JasonStoyanov/athena_pcb/README.adoc

= Athena Project PCB
:hardbreaks-option:

Additional information regarding the hardware can be found in the following article:
https://open4tech.com/how-to-create-a-ble-sensor-beacon-part-1-the-hardware/
