JasonStoyanov/athena_pcb/athena_pcb.xlsx

# | Reference | Qty | Value | Footprint | DNP | Description | MANUFACTURER | MPN | Package
1 | AE1 | 1 | Antenna | RF_Antenna:Texas_SWRA117D_2.4GHz_Right |  | PCB antenna | N.A | N.A | N.A
2 | BT1 | 1 | Battery_Cell | Battery:BatteryHolder_Keystone_1060_1x2032 |  | Bat Holder CR2032 SMD | Keystone | 1060
3 | C1, C2, C4, C5, C7 | 5 | 1uF | Capacitor_SMD:C_0402_1005Metric |  | Capacitor, Ceramic, X5R, ±10%, 25V | Murata | GRM155R61E105KA12D | 0402
4 | C3 | 1 | 2.2nF | GRM033R71C301JA01D:CAPC0603X33N |  | Capacitor, Ceramic, X5R, ±10%, 10V | Murata | GRM033R61A222KA01D | 0201
5 | C6, C8, C9, C10, C11, C13, C14, C15, C16, C18, C19 | 11 | 100nF | GRM033R71C301JA01D:CAPC0603X33N |  | Capacitor, Ceramic, X5R, ±10%, 6.3V | Murata | GRM033R60J104KE19D | 0201
6 | C12 | 1 | 0.7pF | GRM033R71C301JA01D:CAPC0603X33N |  | Capacitor, NP0, ±0.05pF | Murata | GJM0335C1HR70WB01D | 0201
7 | C17 | 1 | N.C | GRM033R71C301JA01D:CAPC0603X33N | DNP | Not mounted/DNP | N.A | N.A | 0201
8 | D1 | 1 | LED | LED_SMD:LED_0603_1608Metric |  | Green LED SMD WL-SMCD | Wurth Electronic | 150060VS55040 | 0603
9 | J2 | 1 | Conn_01x04 | Connector_PinSocket_1.27mm:PinSocket_1x06_P1.27mm_Vertical | DNP | Not mounted/DNP | N.A | N.A | N.A
10 | L1, L2 | 2 | 10uH | LQM18DN100M70L:INDC1608X95N |  | Inductor, 100mA, ±20%, 1.05Ohm | Murata | LQM18DN100M70L | 0603
11 | L3 | 1 | 2.2nH | LQP03HQ2N2B02D:IND_LQP03HQ2N2B02D |  | Inductor, 600mA, ±0.1ｎH, 120mOhm | Murata | LQP03HQ2N2B02D | 0201
12 | R1 | 1 | 200R | Resistor_SMD:R_0402_1005Metric |  | Resistor, ±1%, 62.5 mW | YAGEO | RC0402FR-13200RL | 0402
13 | SW1 | 1 | SW_Push | Button_Switch_SMD:SW_Push_1P1T_NO_CK_KMR2 |  | Tactile Switch SMD | C&K Switches | KMR221NGLFS
14 | TP1, TP2, TP3, TP4 | 4 | TestPoint | TestPoint:TestPoint_Pad_D1.0mm |  | Test point pad | N.A | N.A | N.A
15 | U1 | 1 | NRF5340-QKAA-R7 | NRF5340-QKAA-R7:XCVR_NRF5340-QKAA-R7 |  | Multi-protocol Bluetooth Low Energy system-on-chip | Nordic Semiconductor | nRF5340-QKAA-R7 | aQFN-94
16 | U2 | 1 | BME280 | Package_LGA:Bosch_LGA-8_2.5x2.5mm_P0.65mm_ClockwisePinNumbering |  | BME280 temp and humidity sensor | Bosch Sensortec | BME280 | LGA-8
17 | Y1 | 1 | 32MHz | XRCGB32M000F1H19R0:OSC_XRCGB32M000F1H19R0 |  | XTAL SMD 2016, 32MHz, Cl=9pF, Tol: ±10ppm, Stab: ±10ppm | Murata Electronics | XRCGB32M000F1S1JR0 | XTAL_2016
18 | Y2 | 1 | 32.768kHz | CM8V-T1A-32.768KHZ-9PF-20PPM-TA-QC:XTAL_CM8V-T1A-32.768KHZ-9PF-20PPM-TA-QC |  | XTAL SMD 2012, 32.768kHz, 9pF, ±20ppm | Micro Crystal | CM8V-T1A-32.768kHz-9pF-20PPM-TA-QC | XTAL_2012
