JasonStoyanov/athena_pcb/symbols_footprints/CM8V-T1A-32.768KHZ-9PF-20PPM-TA-QC/CM8V-T1A-32.768KHZ-9PF-20PPM-TA-QC.step

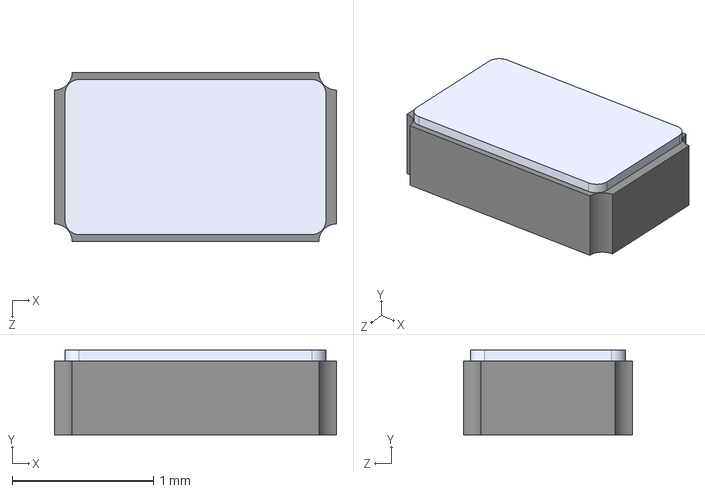
[picture p1: CAD file, 2023-04-21]
symbols_footprints/CM8V-T1A-32.768KHZ-9PF-20PPM-TA-QC/CM8V-T1A-32.768KHZ-9PF-20PPM-TA-QC.step
2.00 x 0.6 x 1.20 mm
