JasonStoyanov/athena_pcb/symbols_footprints/GRM033R71C301JA01D/GRM033R71C301JA01D.step

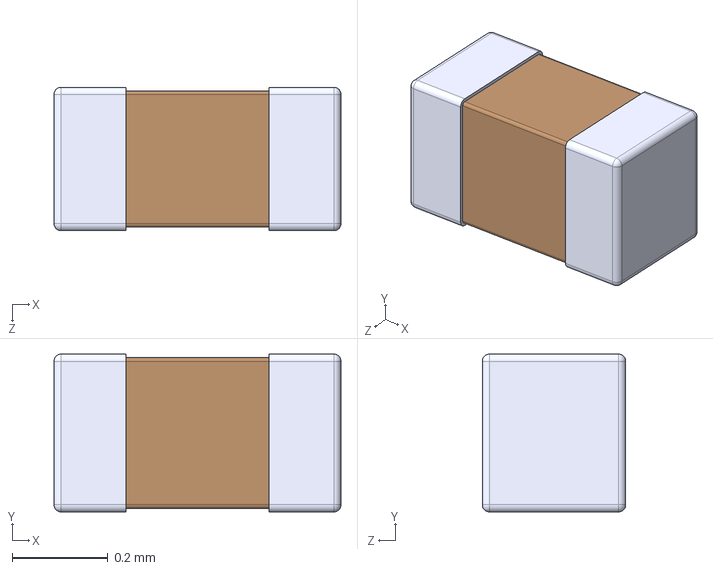
[picture p2: CAD file, 2023-03-07]
symbols_footprints/GRM033R71C301JA01D/GRM033R71C301JA01D.step
0.6 x 0.33 x 0.3 mm
