JasonStoyanov/athena_pcb/symbols_footprints/LQM18DN100M70L/LQM18DN100M70L.step

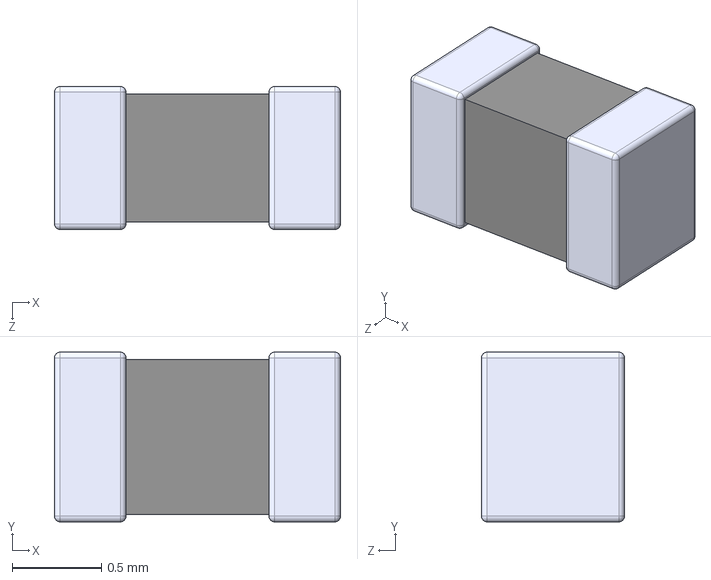
[picture p3: CAD file, 2023-04-21]
symbols_footprints/LQM18DN100M70L/LQM18DN100M70L.step
1.60 x 0.95 x 0.8 mm
