JasonStoyanov/athena_pcb/symbols_footprints/LQP03HQ2N2B02D/LQP03HQ2N2B02D.step

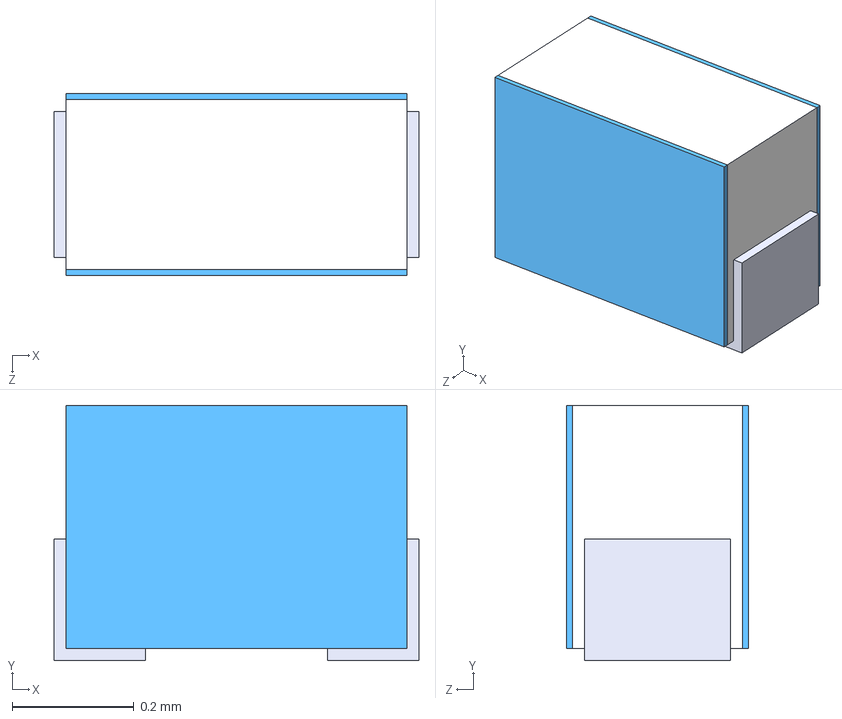
[picture p4: CAD file, 2023-04-21]
symbols_footprints/LQP03HQ2N2B02D/LQP03HQ2N2B02D.step
0.6 x 0.42 x 0.3 mm
