JasonStoyanov/athena_pcb/symbols_footprints/NRF5340-QKAA-R7/NRF5340-QKAA-R7--3DModel-STEP-269445.STEP

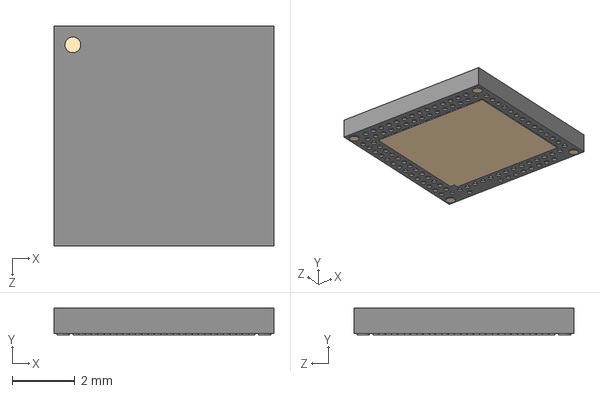
[picture p5: CAD file, 2023-02-18]
symbols_footprints/NRF5340-QKAA-R7/NRF5340-QKAA-R7--3DModel-STEP-269445.STEP
7.00 x 0.85 x 7.00 mm
