JasonStoyanov/athena_pcb/symbols_footprints/XRCGB32M000F1H19R0/XRCGB32M000F1H19R0.step

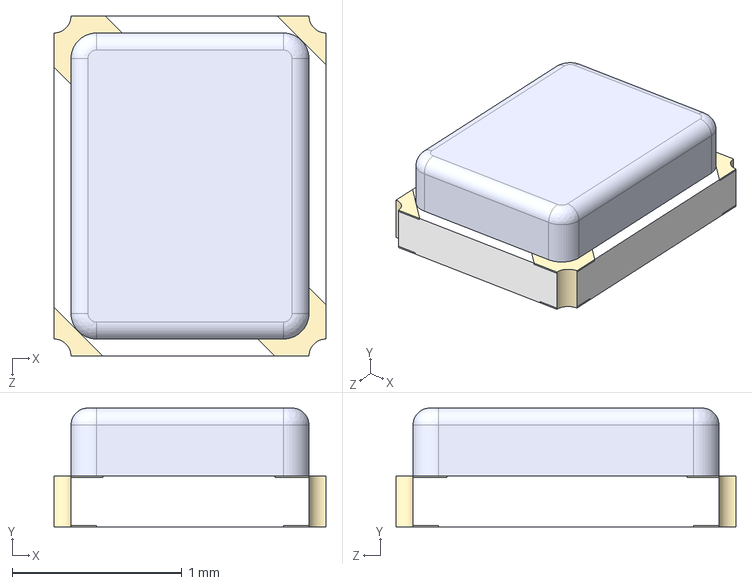
[picture p6: CAD file, 2023-03-25]
symbols_footprints/XRCGB32M000F1H19R0/XRCGB32M000F1H19R0.step
1.60 x 0.7 x 2.00 mm
