JasonStoyanov/athena_pcb/athena_pcb.kicad_pcb

## KiCad design athena_pcb.kicad_pcb (2023-04-21)

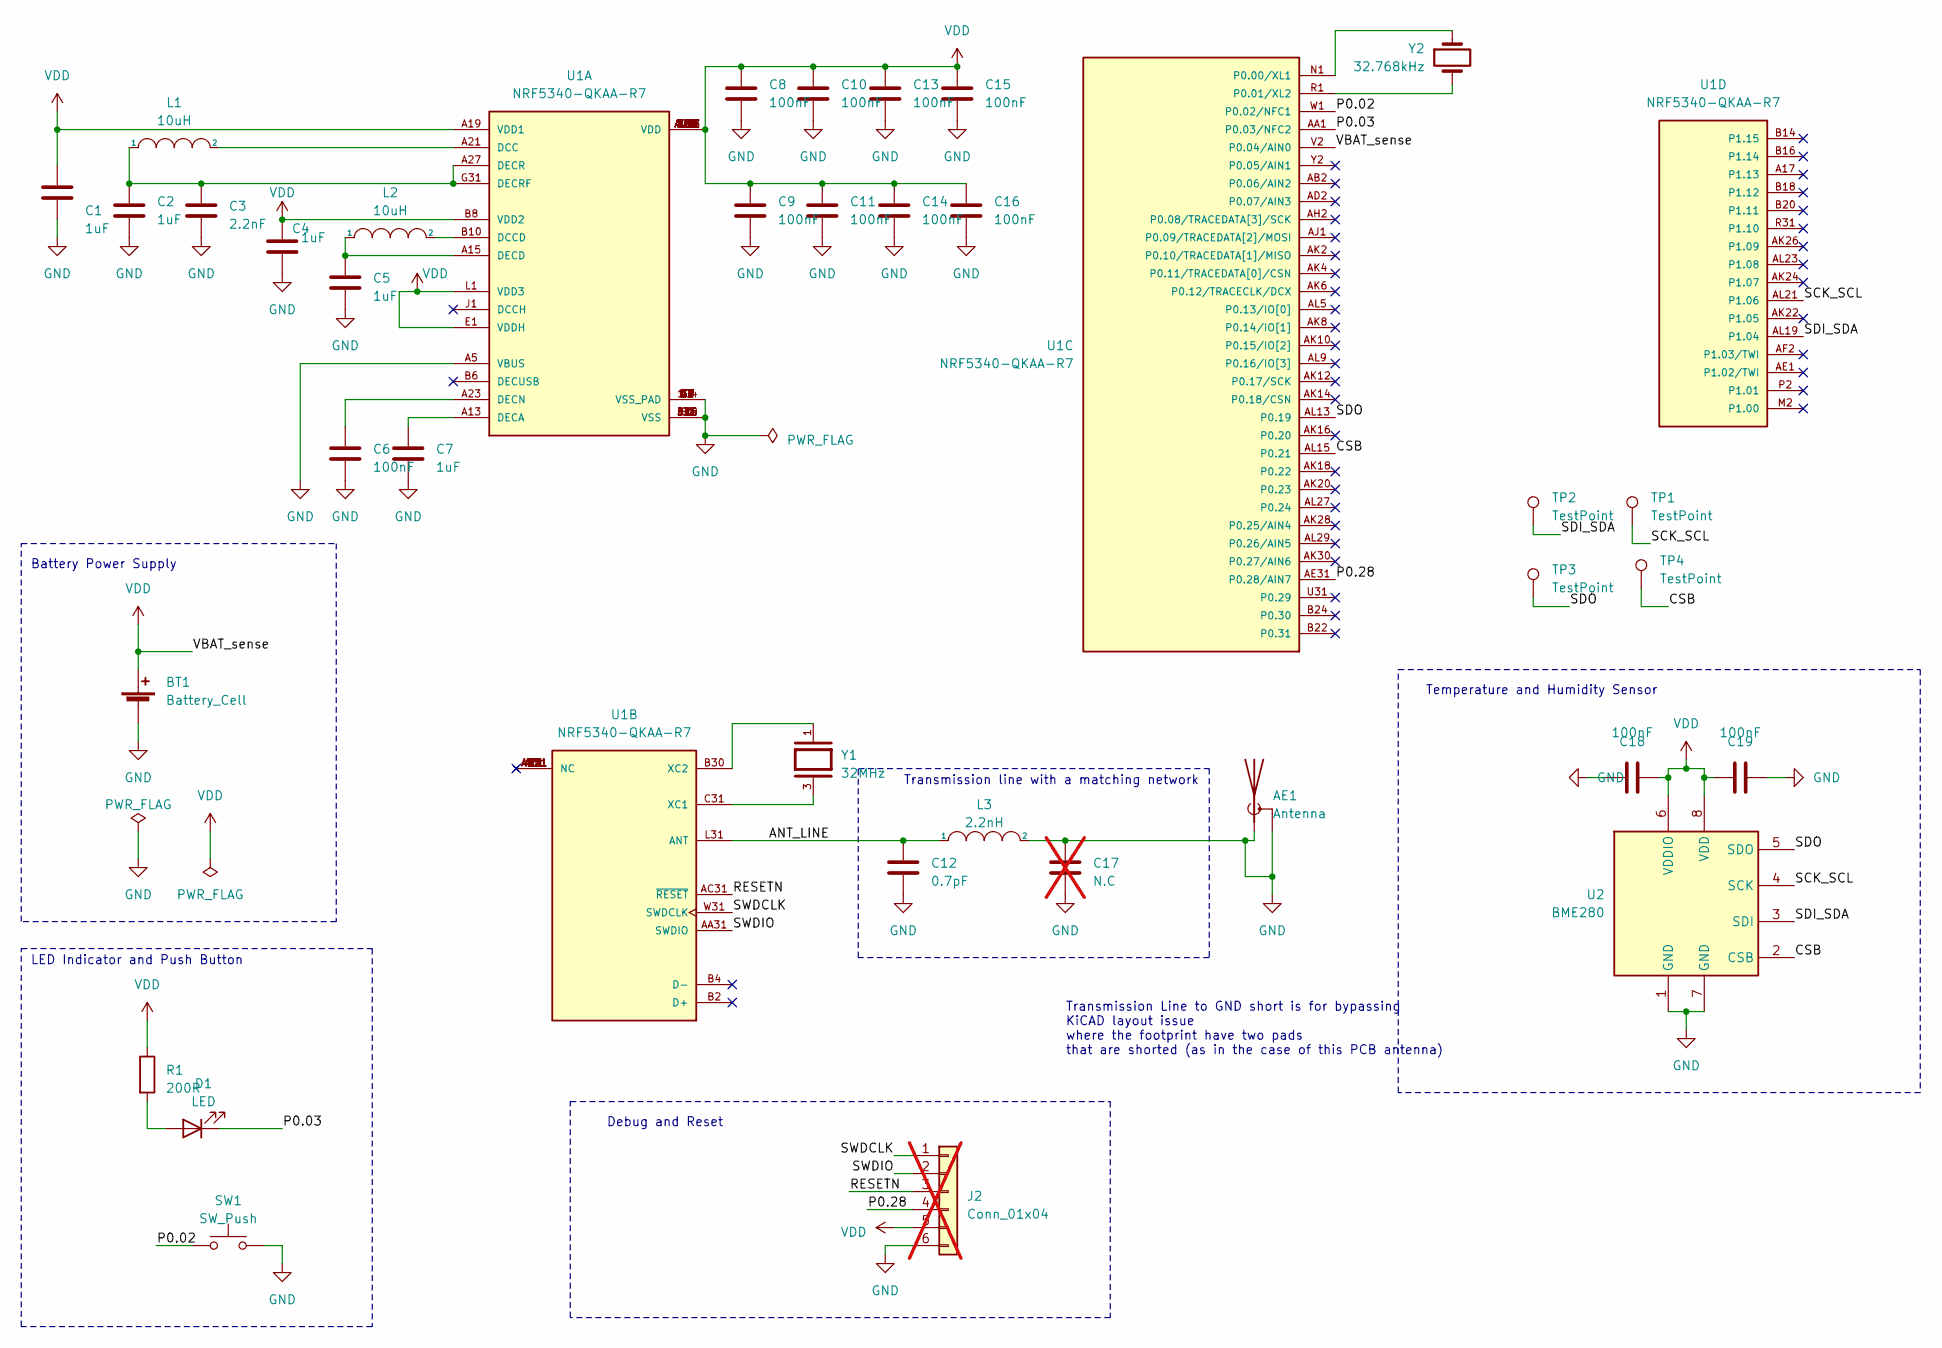
[picture p7: schematic athena_pcb.kicad_sch, Project Athena]

Parts:
AE1: Antenna; Texas_SWRA117D_2.4GHz_Right; MPN N.A
BT1: Battery_Cell; BatteryHolder_Keystone_1060_1x2032; MPN 1060
C1, C2, C4, C5, C7: 1uF; C_0402_1005Metric; MPN GRM155R61E105KA12D
C3: 2.2nF; CAPC0603X33N; MPN GRM033R61A222KA01D
C6, C8, C9, C10, C11, C13, C14, C15, C16, C18, C19: 100nF; CAPC0603X33N; MPN GRM033R60J104KE19D
C12: 0.7pF; CAPC0603X33N; MPN GJM0335C1HR70WB01D
C17: N.C; CAPC0603X33N; MPN N.A; not fitted
D1: LED; LED_0603_1608Metric; MPN 150060VS55040
J2: Conn_01x04; PinSocket_1x06_P1.27mm_Vertical; MPN N.A; not fitted
L1, L2: 10uH; INDC1608X95N; MPN LQM18DN100M70L
L3: 2.2nH; IND_LQP03HQ2N2B02D; MPN LQP03HQ2N2B02D
R1: 200R; R_0402_1005Metric; MPN RC0402FR-13200RL
SW1: SW_Push; SW_Push_1P1T_NO_CK_KMR2; MPN KMR221NGLFS
TP1, TP2, TP3, TP4: TestPoint; TestPoint_Pad_D1.0mm; MPN N.A
U1: NRF5340-QKAA-R7; XCVR_NRF5340-QKAA-R7; PARTREV 1.0
U2: BME280; Bosch_LGA-8_2.5x2.5mm_P0.65mm_ClockwisePinNumbering; MPN BME280
Y1: 32MHz; OSC_XRCGB32M000F1H19R0; PARTREV N/A
Y2: 32.768kHz; XTAL_CM8V-T1A-32.768KHZ-9PF-20PPM-TA-QC; MPN CM8V-T1A-32.768kHz-9pF-20PPM-TA-QC

Connections:
/ANT_LINE: C12.1, L3.1, U1.L31 (ANT)
/CSB: TP4.1, U1.AL15 (P0.21), U2.2 (CSB)
/P0.02: SW1.1, U1.W1 (P0.02/NFC1)
/P0.03: D1.1 (K), U1.AA1 (P0.03/NFC2)
/P0.28: J2.4, U1.AE31 (P0.28/AIN7)
/RESETN: J2.3, U1.AC31 (~RESET)
/SCK_SCL: TP1.1, U1.AL21 (P1.06), U2.4 (SCK)
/SDI_SDA: TP2.1, U1.AL19 (P1.04), U2.3 (SDI)
/SDO: TP3.1, U1.AL13 (P0.19), U2.5 (SDO)
/SWDCLK: J2.1, U1.W31 (SWDCLK)
/SWDIO: J2.2, U1.AA31 (SWDIO)
GND: AE1.1 (A), AE1.2 (Shield), BT1.2 (-), C1.2, C2.2, C3.2, C4.2, C5.2, C6.2, C7.2, C8.2, C9.2, C10.2, C11.2, C12.2, C13.2, C14.2, C15.2, C16.2, C17.1, C17.2, C18.1, C19.2, J2.6, L3.2, SW1.2, U1.35 (VSS_PAD), U1.36 (VSS_PAD), U1.37 (VSS_PAD), U1.38 (VSS_PAD), U1.39 (VSS_PAD), U1.40 (VSS_PAD), U1.41 (VSS_PAD), U1.43 (VSS_PAD), U1.44 (VSS_PAD), U1.45 (VSS_PAD), U1.46 (VSS_PAD), U1.47 (VSS_PAD), U1.48 (VSS_PAD), U1.49 (VSS_PAD), U1.50 (VSS_PAD), U1.51 (VSS_PAD), U1.104 (VSS_PAD), U1.A5 (VBUS), U1.A25 (VSS), U1.B12 (VSS), U1.B26 (VSS), U1.G1 (VSS), U1.H2 (VSS), U1.J31 (VSS), U2.1 (GND), U2.7 (GND)
unnamed: D1.2 (A), R1.2
unnamed: L1.2, U1.A21 (DCC)
unnamed: L2.2, U1.B10 (DCCD)
unnamed: C7.1, U1.A13 (DECA)
unnamed: C5.1, L2.1, U1.A15 (DECD)
unnamed: C6.1, U1.A23 (DECN)
unnamed: C2.1, C3.1, L1.1, U1.A27 (DECR), U1.G31 (DECRF)
unnamed: U1.C31 (XC1), Y1.3
unnamed: U1.B30 (XC2), Y1.1
unnamed: U1.N1 (P0.00/XL1), Y2.1
unnamed: U1.R1 (P0.01/XL2), Y2.2
VDD: BT1.1 (+), C1.1, C4.1, C8.1, C9.1, C10.1, C11.1, C13.1, C14.1, C15.1, C16.1, C18.2, C19.1, J2.5, R1.1, U1.A19 (VDD1), U1.AC1 (VDD), U1.AG1 (VDD), U1.AJ31 (VDD), U1.AL3 (VDD), U1.AL7 (VDD), U1.AL11 (VDD), U1.AL17 (VDD), U1.AL25 (VDD), U1.B8 (VDD2), U1.B28 (VDD), U1.C1 (VDD), U1.E1 (VDDH), U1.E31 (VDD), U1.L1 (VDD3), U1.N31 (VDD), U1.U1 (VDD), U1.V2 (P0.04/AIN0), U2.6 (VDDIO), U2.8 (VDD)

Notes on the sheet:
Battery Power Supply
Debug and Reset
Transmission line with a matching network
Temperature and Humidity Sensor
LED Indicator and Push Button
Transmission Line to GND short is for bypassing KiCAD layout issue where the footprint have two pads that are shorted (as in the case of this PCB antenna)

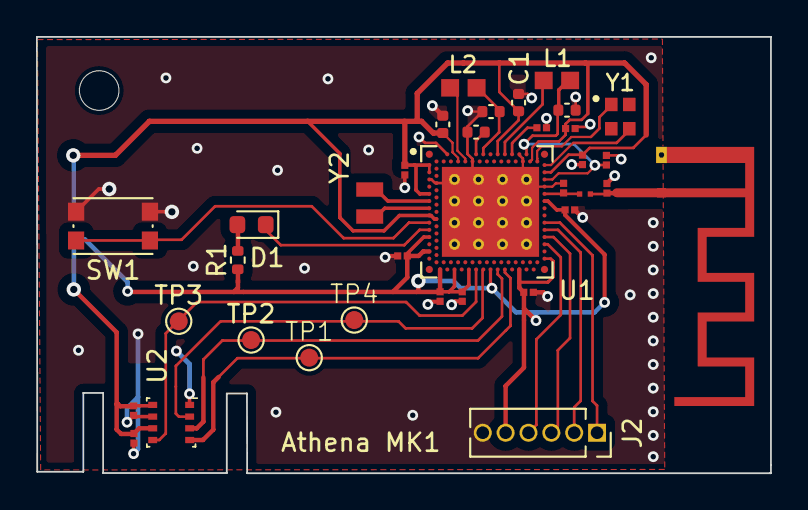
[picture p8: board athena_pcb.kicad_pcb from above]

Board: 2 copper layers, 40.8 x 24.2 mm, 36 parts (1 on the bottom side), 24 nets.
