JasonStoyanov/athena_pcb/(commit log)

2023-02-06 Power and Ground connection as per reference schematic
    [athena_pcb.kicad_sch]
2023-02-07 Additional connections made
    [athena_pcb.kicad_sch]
2023-02-11 BME280 shcematic done
    [athena_pcb.kicad_sch]
2023-02-13 Updated to KiCAD 7. Added VBAT Sense
    [athena_pcb.kicad_sch]
2023-02-14 Added user button and indicator LED
    [athena_pcb.kicad_sch]
2023-02-18 Added footprint to capacitors
    [athena_pcb.kicad_pcb, athena_pcb.kicad_sch]
2023-02-18 Added footprint and symbol for the NRF53
    [NRF5340-QKAA-R7.step, athena_pcb.kicad_pcb, athena_pcb.kicad_sch]
2023-02-20 Added board layout constraints
    [athena_pcb.kicad_pcb, athena_pcb.kicad_sch]
2023-02-23 Layout around NRF53 done
    [athena_pcb.kicad_pcb, athena_pcb.kicad_sch]
2023-03-07 Added new 0201 capacitor footprint
    [GRM033R71C301JA01D.step, athena_pcb.kicad_pcb, athena_pcb.kicad_sch]
2023-03-15 Added board outline
    [NRF5340-QKAA-R7--3DModel-STEP-269445.STEP, athena_pcb.kicad_pcb, athena_pcb.kicad_sch]
2023-03-20 Added testpoints
    [athena_pcb.kicad_pcb, athena_pcb.kicad_sch]
2023-03-22 Added Vias acc. to PCB fab
    [athena_pcb.kicad_pcb]
2023-03-24 Adapted PCB antenna footprint to use polygon, Workaroung for schematic symbol
    [athena_pcb.kicad_pcb, athena_pcb.kicad_sch]
2023-03-25 Added proper Y1 symbol and footprint
    [XRCGB32M000F1H19R0.step, athena_pcb.kicad_pcb, athena_pcb.kicad_sch]
2023-03-27 Polishing layout
    [athena_pcb.kicad_pcb, athena_pcb.kicad_sch]
2023-03-28 Updated Header pinout, added ground pours to PCB
    [athena_pcb.kicad_pcb, athena_pcb.kicad_sch]
2023-03-31 Changes from the review
    [athena_pcb.kicad_pcb]
2023-04-03 Added items in the BOM
    [athena_pcb.kicad_pcb, athena_pcb.kicad_sch]
2023-04-06 Bom updated, not connected added to nrf53 pins
    [athena_pcb.kicad_sch]
2023-04-08 Cleaned Track not connected Warnings
    [athena_pcb.kicad_pcb]
2023-04-08 Updated tracks to 6mils where possible
    [athena_pcb.kicad_pcb]
2023-04-10 Added edge clearence, transmission line width to match with pcb antenna feed
    [athena_pcb.kicad_pcb, athena_pcb.kicad_sch]
2023-04-21 Version sent to PCB manufacturer
    [CM8V-T1A-32.768KHZ-9PF-20PPM-TA-QC.step, LQM18DN100M70L.step, LQP03HQ2N2B02D.step, athena_pcb.kicad_pcb, athena_pcb.kicad_sch, athena_pcb.xlsx]
